Minorplanets76/Open-Tag-Reader/ESP32 Boards/T-Embed/info.md

### T-Embed
This was the initial board I trialled.  I have decided to move away from this board to AMOLED Touch version from Lilygo.
[The Github repostitory can be found here](https://github.com/Xinyuan-LilyGO/T-Embed)
