Minorplanets76/Open-Tag-Reader/RFID Modules/WL134A/info.md

### WL134A RFID Module

#### Overview
I found this module on [Aliexpress](https://www.aliexpress.com/item/1005005527774729.html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,scm-url:1007.40050.354490.0,pvid:1610bac3-e44d-44ca-a5d6-faea2dcb6218,tpp_buckets:668%232846%238107%231934&pdp_npi=4%40dis%21AUD%2145.81%2138.49%21%21%2130.46%2125.59%21%402101ef7017204727855125053e5b6c%2112000033424318969%21rec%21AU%21136852735%21&utparam-url=scene%3ApcDetailTopMoreOtherSeller%7Cquery_from%3A).  It comes with a 70mm and 150mm coil and a capicitor to suit.  I have made a simple carrier board that includes a mini boost supply, a trimmer capacitor, and a couple of voltage dividers for compatability with the 3.3V Esp32.  I has a slighty more challenging interface.  It's smaller and a bit cheaper.
