Minorplanets76/Open-Tag-Reader/Code/OTR-T-Display-AMOLED-Plus/cache/thumb_1126509772opensourcehardware.png

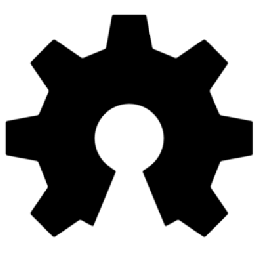
Code/OTR-T-Display-AMOLED-Plus/cache/thumb_1126509772opensourcehardware.png
