Minorplanets76/Open-Tag-Reader/Code/OTR-T-Display-AMOLED-Plus/data/otrT_Display_data_layout.png

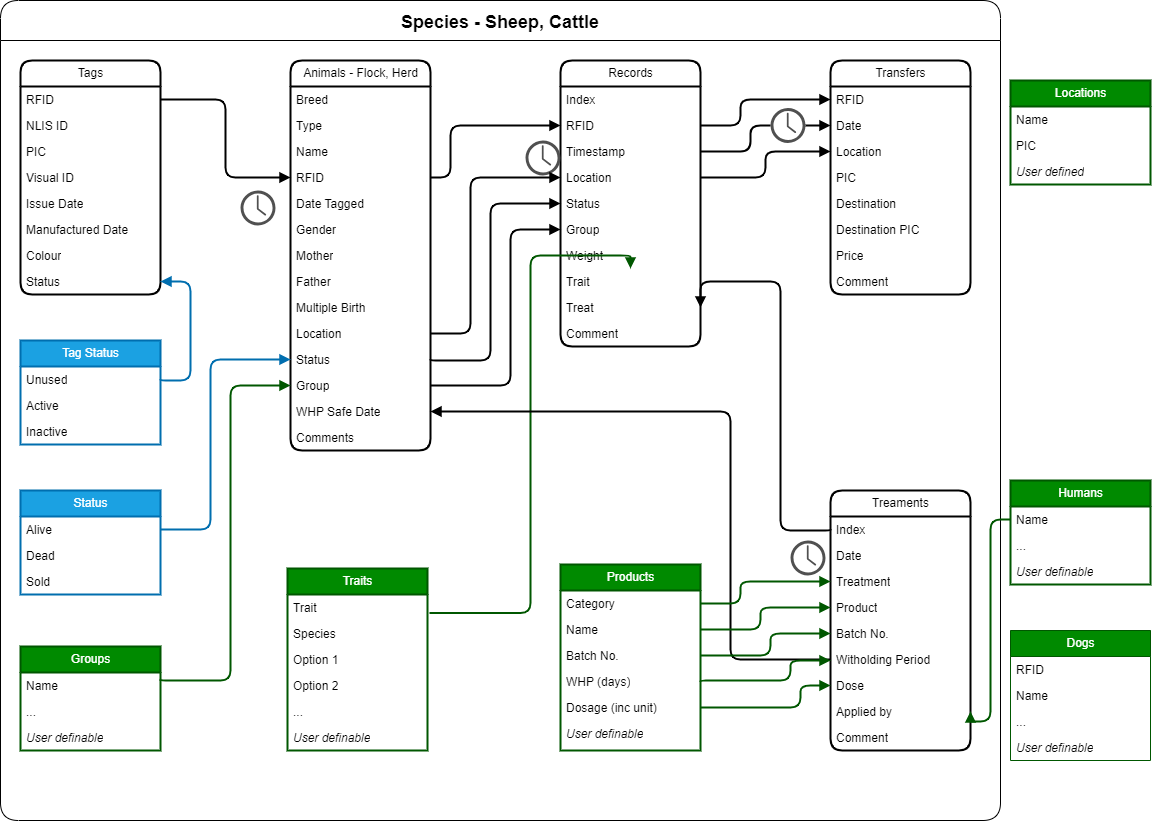
Code/OTR-T-Display-AMOLED-Plus/data/otrT_Display_data_layout.png
