Minorplanets76/Open-Tag-Reader/3d_print_files/Coil reader - Shroud.3mf

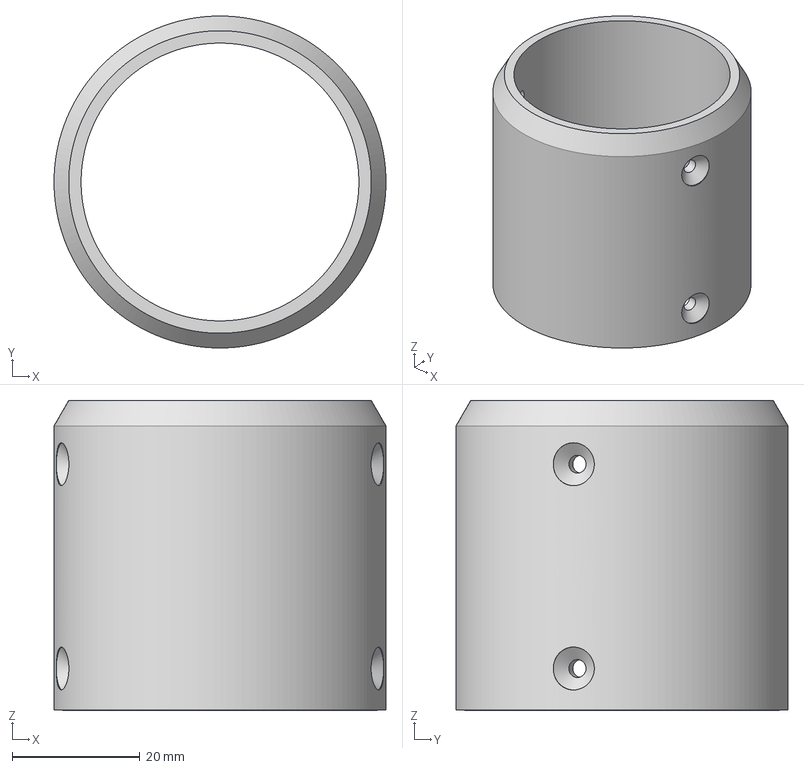
[picture p4: CAD file, 2024-03-14]
3d_print_files/Coil reader - Shroud.3mf
52.0 x 52.0 x 48.6 mm
