Minorplanets76/Open-Tag-Reader/3d_print_files/Coil reader.3mf

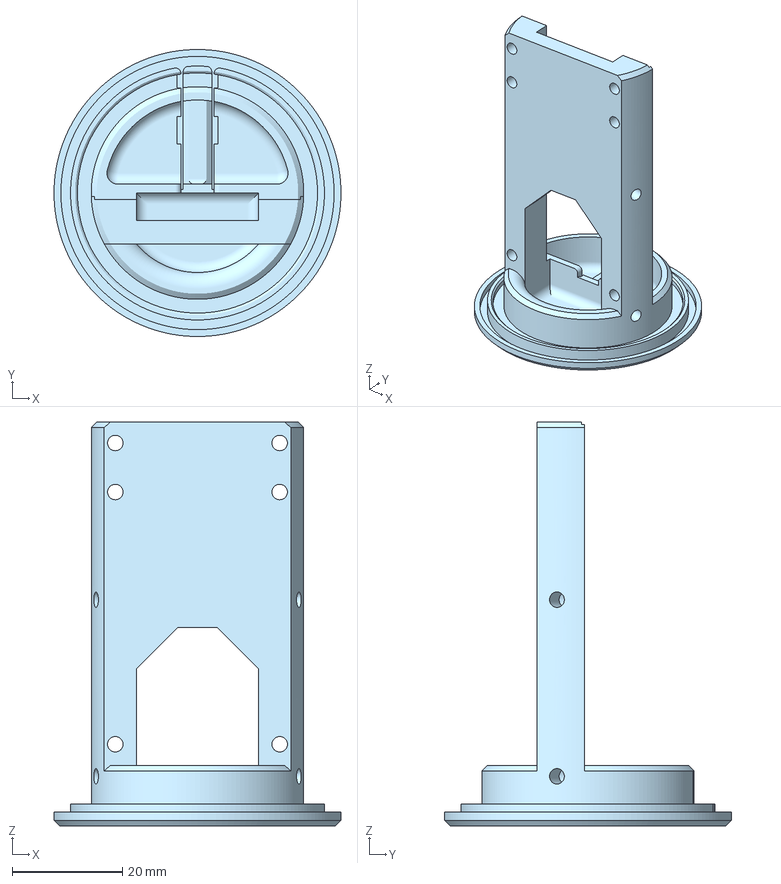
[picture p5: CAD file, 2024-03-14]
3d_print_files/Coil reader.3mf
52.0 x 52.0 x 73.2 mm
Coil Carrier
