Minorplanets76/Open-Tag-Reader/RFID Modules/WL134A/WL-134A-Instructions Page1.png

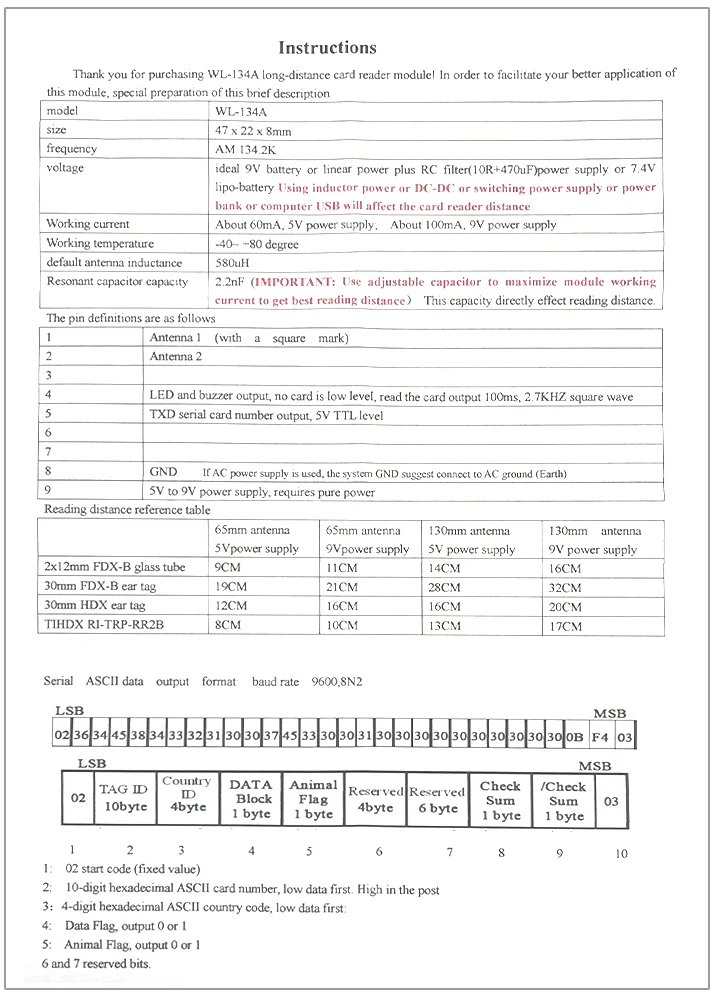
RFID Modules/WL134A/WL-134A-Instructions Page1.png
