Minorplanets76/Open-Tag-Reader/(threads)

Thread 1 (2025-05-26):

Build guide for beginners

brendan-pike, 2025-05-26:
Hi Chris

Using a ticket as I couldn't find any contact info for you.  As a hobby-farm with 10 sheep in South Aus. I'm needing an etag reader and this looks perfect.   While I'm reasonably technical I find the build instructions currently too lite and also segmented.   I think hardware pictures would be very helpful and more details especially around the firmware flashing and sources for where 3d printing can be purchased for those not owning a 3d printer.

I would be willing to help but will need assistance to get rolling, what are you thoughts and current situation?

Minorplanets76, 2025-05-29:
G'day Brendan,

The project is languishing in software hell at the moment!  I'm aware it's
a bit of a mess.  Thanks for taking a look at the project though.  I have a
prototype which scans OK, but I never quite finished it, and it has
a problem with power usage.  I'm prone to distraction and have quite a few
projects on the go.

The software needs some work, but I returned to the project at Easter,
tidied up the code but started with a new display board that avoids needing
extra parts.  I need to do up a new circuit board and shroud to attach the
display to a piece of conduit.  I've also been messing about with it
serving a webpage to a phone or tablet, but I probably just need to get the
prototype tidied up first.  I'm a bit out of my depth on the webpage stuff.

I'm using PlatformIO via VScode for the programming.  I've 3D printed the
antenna/board carrier for the scan end, and bits to hold the displays and
switches at the other end.  I hadn't given a lot of thought about how
people without printers might go about it.  I'm using PCB carrier boards
and use surface mount parts which might also be a barrier to people wanting
to make one, but a lot of the board houses also have fabrication
facilities these days.  I mess around with this stuff because I enjoy it,
but I could look at how someone could order the boards assembled along with
the prints in one go, which would just leave the reader board, display, and
a couple of components to purchase separately.

In short, I need to stop procrastinating, and running off on side projects
that aren't necessary.  My plan was to get the new board working on a
breadboard this weekend.

I have a fulltime job as well as a small farm, so I really only get an hour
or two here or there to mess around with it, but I have plenty of ideas
around what I would like it to do mainly working towards weighing, keeping
LPA compatible records, handling NLIS transfers, and monitoring traits.  I
would assume this would suit smaller producers.  I have between 100-150
ewes (Aussie Whites) for prime lamb production and do a bit of cropping and
hay as well, but my job means I can mess about with trials and experiments
without going broke.

Staying on track and actually finishing things is probably my weak point.
I'm happy for collaboration.  Web stuff, documentation, and tuning RF
antennas are things that would be helpful.  Testing as well as design
revision is going to be needed.

Thanks again for the interest

Chris

On Mon, May 26, 2025 at 12:59 PM DB Informatics ***@***.***>
wrote:

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

brendan-pike, 2025-06-03:
Great response and overview Chris.  I'm similar to you in that I juggle many projects at once and my attention often moves to the least stressful so some stall.  While I'm not a programmer I manage web stuff reasonably well, I run nginx servers and can work html/css if that's useful.

I also saw https://github.com/glecuy/AllFlexReader but not much happened since and yours seems the most on its way towards something workable.  If your happy to guide me a bit when I get stuck I'll buy the parts and see how I go, I should be able to work on documentation and the web side once I understand things.

Do you have much experience with 3d printing and what models present good value now days?

Minorplanets76, 2025-06-13:
This project uses modules that have already solved the HDX decoding.  I assume it will read all tags but I have only tested Shearwell branded sheep tags.  It also picks up my dogs microchip!

I am planning on having a web interface to ensure compatability with phones and tablets.  It's early days for that.  Help or ideas would be appreciated.

I have a Bambulab X1 Carbon 3D printer and highly recommend it but any consumer grade printer would be fine.  It probably isn't even necessary.  You just need a way to contain the reader coil.

In your case you could get away with the [USB version](https://www.priority1design.com.au/shopfront/index.php?main_page=product_info&cPath=1&products_id=9) of the reader board and a laptop, then all you need to do is solder the antenna to the board and read the tags via serial.  I've created a stick reader style, and included some more features like feedback and counting, but the intent is to expand it to animal management, so having the data onboard with associated software is where I'm at.

I've had quite few thoughts about its form.  A stick reader seams sensible, but I've thought about wrist mounted versions so you can just drench and scan in one motion, or extendable ones so you can identify one before they are in the race.  If I end up going down the weighing route it will probably turn into a panel reader.  In the end my 3D printed parts are whimsical design on my part.  It's probably more efficient to just tape the parts together!

brendan-pike, 2025-06-13:
True I'd probably get away with just a USB to laptop, but I would like to try build something others could use without a PC and the costs don't seem that much, means I might be able to test and contribute better with the web side too.
Is your build_instructions.md up to date, if so I'll order the FDX-B/HDX RFID serial version and a T-Embed.

Minorplanets76, 2025-06-16:
No, don't buy the T-Embed. Buy the T-Display AMOLED Plus. I will update the build instructions.

Minorplanets76, 2025-06-27:
Great!  To clarify do you have  the [T-Display Plus](https://lilygo.cc/products/t-display-s3-amoled-plus) or the regular [T-Display AMOLED](https://lilygo.cc/products/t-display-s3-amoled?variant=43506902335669)?  I see the regular version has the same black shell as the plus version now.

To get yourself started follow the instructions on LilyGo's [Github](https://github.com/Xinyuan-LilyGO/LilyGo-AMOLED-Series) page and follow the upload instructions.  I normally upload one of their touchscreen examples to check it's working.  All on my boards have needed to press the boot/reset buttons to go into upload mode, probably because I'm using the serial for development.

I will check this weekend if I can make it work with the board just plugged into USB.  I think it should, and that would avoid a bit of electronics.  I'm poking along with the code but mainly on basic functionality still.

brendan-pike, 2025-06-27:
I checked and I have purchased the T-Display Plus.  I'll have a go following LilyGo's instructions tonight. :)

Minorplanets76, 2025-07-02:
The display definitely shouldn't be blank.  Did you flash a Lilygo example?  I use PlatformIO in VSCode, mostly because of the convenient code editting, but you should be able to flash the compiled bin file via the esp tool as well, but I've never tried it because I'm usually fiddling with the code.  You may need to do the press the reset/boot button combination mentioned on Lilygos guide in order to force it into flash mode.

64GB would be many thousands of sheep.  You also need to upload the filesystem image to give the ESP some internal space.

The antenna has to ends, one gets soldered to A+ and the other A-.  It doesn't matter which way around.

it's important to connect to J2 on the reader board as we need 3.3V logic.

I tested powering the reader board and the display via USB and it works fine.  In this configuration you only need 3 wires.   V+ wired to one of the VBUS pins, V- (middle pad) to a Ground Pin, and TX to GPIO42.

brendan-pike, 2025-07-03:
Okay, so another update. I found if I re-flash the lilygo factory I get the screen working again, but when flashed with your code I get a blank screen.  I see they have two T-Display-AMOLED versions, I assume you have the newer second one same as me?

I did my best guess as to the wiring, here is a couple of pics, could you please check if I did it correctly?

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

brendan-pike, 2025-07-09:
I did the build/ upload filesystem but no change yet.  On the terminal output all I get is this:
`           Connected!
[  9276][E][Wire.cpp:499] requestFrom(): i2cWriteReadNonStop returned Error -1
0000111
0000111
000011
[ 61671][E][Wire.cpp:499] requestFrom(): i2cWriteReadNonStop returned Error -1
`
Also, can you confirm if it is normal that the reader Q4 component gets too hot to touch?

brendan-pike, 2025-07-12:
I've taken a look at the html, I take it this is all just static example data currently.   What is your goal with regards to the html, how do you see if functioning? From the example data is seems you were intending to run an animal management system which I would of thought isn't the right place to be storing your animal data but rather exporting somehow?

brendan-pike, 2025-07-25:
Okay my tags finally arrived.  Previously I was trying to sense my dogs RFID without luck now I have my tags I can not sense them either.  My tags are called [RapID Evo](https://www.allflex.com.au/product/electronic-tag-rapid-evo/) by Allflex.

I've rechecked my wiring and everything appears the same as yours, I also confirmed the ESP is passing 5v to the reader which is also evident because as mentioned I can't hold my finger on Q4.

In the terminal all I get is this:

```
03:46
getBatteryVoltage - Battery Voltage: 0mV
checkChargeStatusCharge Status: Charging
Update Battery Image - V = 0 Charge status = 1
03:47
getBatteryVoltage - Battery Voltage: 0mV
checkChargeStatusCharge Status: Charging
Update Battery Image - V = 0 Charge status = 1
03:47
getBatteryVoltage - Battery Voltage: 0mV
checkChargeStatusCharge Status: Charging
Update Battery Image - V = 0 Charge status = 1
```
Any ideas where to go from here?

Regarding html work, is there a way to swap the ESP to joining a wifi nextwork, this would make working on it easier as I could do it from my desktop?

Minorplanets76, 2025-07-26:
I have a couple of rams with those tags so I can confirm they work

On Fri, 25 Jul 2025 at 6:23 pm, DB Informatics ***@***.***>
wrote:

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

brendan-pike, 2025-07-29:
When I short L+ & L- I get nothing on the ESP or logs, so I guess my reader is fried, grrr.  Will have to order a new one, I wonder if I did that early on mis-wiring it.

brendan-pike, 2025-08-07:
I've ordered a new reader, I'll send the old one back to Robert and see if he can tell what happened to it.

brendan-pike, 2025-08-12:
I received the new board today.  I wired it in the same as the last board, plugged the ESP into my PC for power and instantly got the same result, a chip too hot to touch, so I disconnected immediately.  Very disappointed I can't figure this out. I've taken detailed pictures again, with the 3 wires needed. I disconnected the antenna which made no difference.
Can you please sanity check my wiring.  Beyond that, what could it be?

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

Minorplanets76, 2025-08-12:
In your last picture it looks like you've connected your black wire to VO and not V-.  If you read the datasheet you will find that the second pin is a regulated Voltage out which we're not using.  The black wire needs to be to **V-** (the middle pin).

What has me confused, is your original picture had a green wire in V+ a yellow wire in V- and black and red connected to RX & TX.  Unconventional colouring but as long as they are connected correctly on the power side, colour doesn't matter.  I have created a carrier board for the T-display plus that just has a 5 pin connection that connects straight to the reader with a pre-built 5 pin Jst xh cable.  Only 3 wires are used, but it should eliminate wiring mistakes.  The board also includes a 4 wire connection for an on/off switch with led and a 2 wire connector for a battery.  I put a small boost regulator on it to feed the reader board 9V, and a mosfet so the reader board can be turned on and off to conserve battery.  I also put in a circuit to  drive a buzzer for audible feedback but annoyingly that doesn't appear to be working.  The reader board definitely doesn't get hot.

[20250812_193626.jpg](https://github.com/user-attachments/assets/5f317c53-8a36-4abe-bf12-65aa80011498)

Here's what I mean about using an led to test the board independently of the display...
https://github.com/user-attachments/assets/3d01b0e4-aa65-4091-8fbb-fc875fa0e537
