Minorplanets76/Open-Tag-Reader/RFID Modules/WL134A/Schematic_WL-134A-Carrier-Board_2025-03-29.pdf

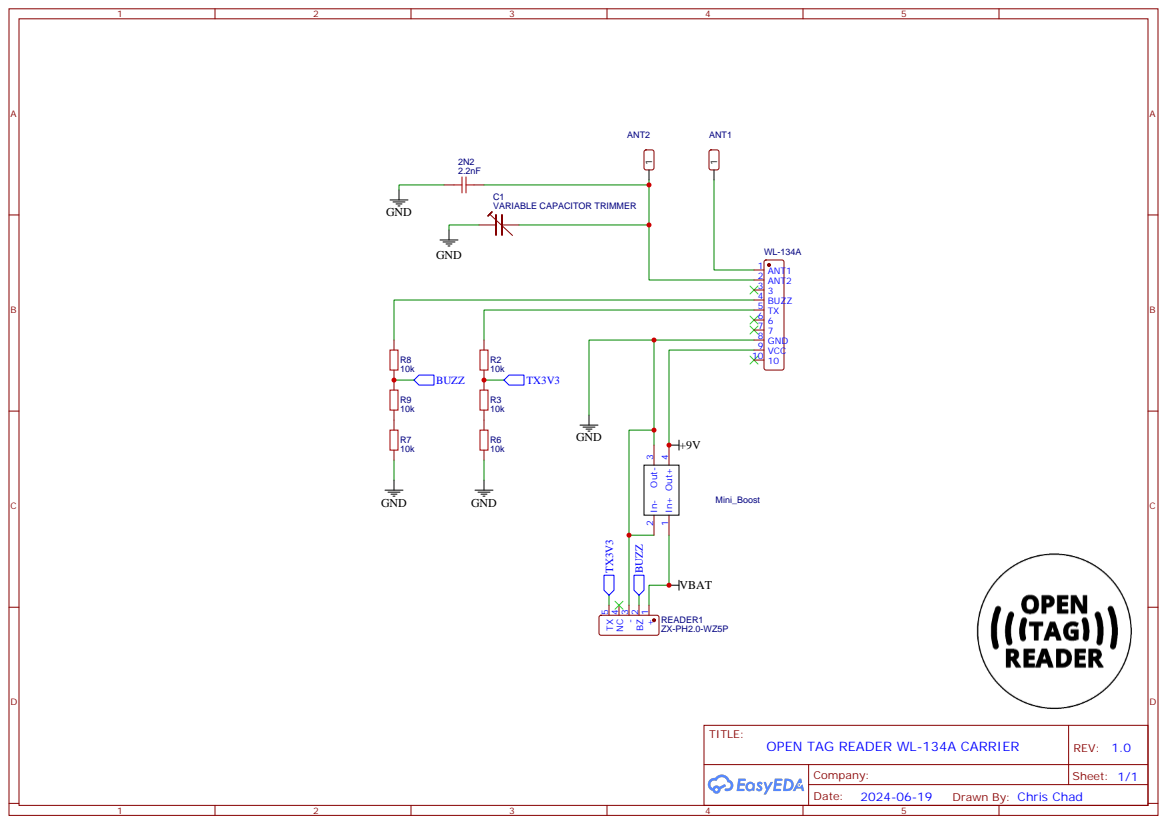
[picture p8: page 1]

Drawn By: Chris Chad
