Minorplanets76/Open-Tag-Reader/(list of files, drawings)

Other design files:
RFID Modules/WL134A/PCB_PCB_WL-134A-Carrier-Board_2025-03-29.json
RFID Modules/WL134A/SCH_WL-134A-Carrier-Board_2025-03-29.json
