Minorplanets76/Open-Tag-Reader/Code/OTR-T-Display-AMOLED-Plus/src/OTR_AMOLED_UI_events.py

def btn_event_cb(event_struct):
    return


def setTimeManual(event_struct):
    return


def setDateManual(event_struct):
    return


def UI_MAIN_SCREEN_LOAD(event_struct):
    return


def TopPanelScanChecked(event_struct):
    return


def TopPanelScanUnchecked(event_struct):
    return


def TopPanelScanPressed(event_struct):
    return


def scanSwitched(event_struct):
    return


def timeSetScreenLoad(event_struct):
    return


def timeTabSelected(event_struct):
    return


def dateTabSelected(event_struct):
    return


def timeScreenLoaded(event_struct):
    return


def setTimeTabChange(event_struct):
    return


def SetTimeScreenLoaded(event_struct):
    return
