Minorplanets76/Open-Tag-Reader/(commit log)

2024-03-14 Tidy files
    [Coil reader - Shroud.3mf, Coil reader.3mf]
2024-04-10 LEDs working
2025-04-04 Rename ESP32 Boards/T-Display S3T-Display S3 AMOLED Touch/info.md to T-Display S3 AMOLED Touch/Info.md
2025-04-04 Rename T-Display S3 AMOLED Touch/Info.md to ESp32 Boards/T-Display S3 AMOLED Touch/Info.md
